IceCube20/JBC-FAE-Emulator/README.md

# JBC FAE Emulator – Control Your Own Fume Extractor with Your JBC Soldering Station Without the Original JBC FAE

> **New Projekt: Open Fume Extractor https://github.com/IceCube20/Open-Fume-Extractor**
> **Current development version:** **v2.3.66RC**  **Only ESP32**
> The original **V1.0** version is still part of this project.
This code runs on ESP32 and Arduino Mega.
Dual Bus (Max 2 JBC Soldering Stations).
With JBC DDE or DME you can set the relay afterrun in the Stations! The lower Models must the afterun configured in the Controler CLI (Arduino IDE Console).

**Emulates a JBC FAE base unit** with a robust P02 parser (DLE byte-stuffing, XOR BCC) on **two independent buses**.  
LED status (SK6812), relay after-run, persistence (NVS/EEPROM), and **RS-232 via MAX3232**.

> CLI over USB @ **115200**. Bus UARTs @ **250000 8E1**.  
> RS-232: **MAX3232** (3.0–5.5 V) converts between MCU-TTL (3V3/5V) and ±RS-232.

---

## Features

- **Dual bus** (BUS_COUNT=1|2), each bus with its own **DeviceID** & **address**
- **Relay** with **after-run** Configuring in the DDE and for lower Station Models over the CLI
- **Auto-save** for writes (debounced)
- **SK6812 GRBW** link/status per bus
- **Persistence**: ESP32 = **NVS** / Mega = **EEPROM**
- **RS-232** per bus via **DSub9 MAX3232 to ttl**

---

## CLI Example

-[NVS]
- bus0 DeviceID len=30 ascii="84495820251031014257F283" | addr=0x18
- bus1 DeviceID len=30 ascii="84495820251031014332F283" | addr=0x12
- [CLI] type 'help' for commands
- [CFG] buses=2 | tstop(w/s)=10/0 | selectflow=100 | suctionlevel=3 | stand_intakes=1 | filter(life/sat)=0/0 | stat_error=0 (0x0)
- [FW] 02:F2:EMU_02:8881031:0051123 | by IceCube20 | build Oct 31 2025 00:21:44
- > Commands:
- help                     - Show this Help
- ?                        - Show DEVID/Addr and other Data) 
- show cfg                 - Show the actual Configuration
- show buses               - Show actual selected Buscount
- set buses <1|2>          - select one or two JBC Stations to connect
- save / load              - Save or Load configuration Data from EEPROM
- erase [eeprom]           - clear NVS/EEPROM and reload defaults (use 'save' to persist) 
- set tstop_work <sec>     - Select the Relay afterrun time in seconds (for the DDE, you can set it up in the Stations Menu)
- set tstop_stand <sec>    - No function! Its for internal testing
- set suctionlevel <0..3>  - No function! Its for internal testing
- set selectflow <0..1000> - No function! Its for internal testing
- set stand_intakes <0|1>  - No function! Its for internal testing
- set filter_life <u16>    - Set your own Filterlife in % (shown in JBC DDE FAE Menu)
- set filter_sat <u16>     - Set your own Filtersaturation in % (shown in JBC DDE FAE Menu)
- STOPx/WARNx, NOERR, ERR  - STOP1-11 Set Station errors, WARN1-2 Set Station warnings, NOERR resets Stations errors or warnings and ERR show all Error and Warnings they exist

---

## Legal Notice

This project re-implements only functional protocol behavior (P02) for interoperability purposes.  
It contains no OEM firmware, no cryptographic keys, and does not circumvent any technical protection measures.  
Protocol constants, enums, and IDs are interface identifiers required for device communication.  
“JBC” is a trademark of its respective owners; this is an unofficial, independent project not affiliated with JBC S.A.

---

## Hardware & Pins

### ESP32 (defaults)

| Function | Pin |
|---:|:---:|
| BUS0 RX (Serial1) | 16  |
| BUS0 TX (Serial1) | 17  |
| BUS1 RX (Serial2) | 32  |
| BUS1 TX (Serial2) | 33  |
| SK6812 **LED_PIN** | 21  |
| Relay **RELAY_PIN** | 26  |
| MAX3232 **VCC** | 3V3 |

### Arduino Mega 2560 (defaults)

| Function | Pin |
|---:|:---:|
| BUS0 RX (Serial1) | 19 (RX1) |
| BUS0 TX (Serial1) | 18 (TX1) |
| BUS1 RX (Serial2) | 17 (RX2) |
| BUS1 TX (Serial2) | 16 (TX2) |
| SK6812 **LED_PIN** | 6 |
| Relay **RELAY_PIN** | 7 |
| MAX3232 **VCC** | 5V  |

> **Note:** MAX3232 works with **3.3 V (ESP32)** and **5 V (Mega)**.  
> **GND** must be **common** between MCU and MAX3232.

---

## Wiring Diagram ESP32

<p align="center">
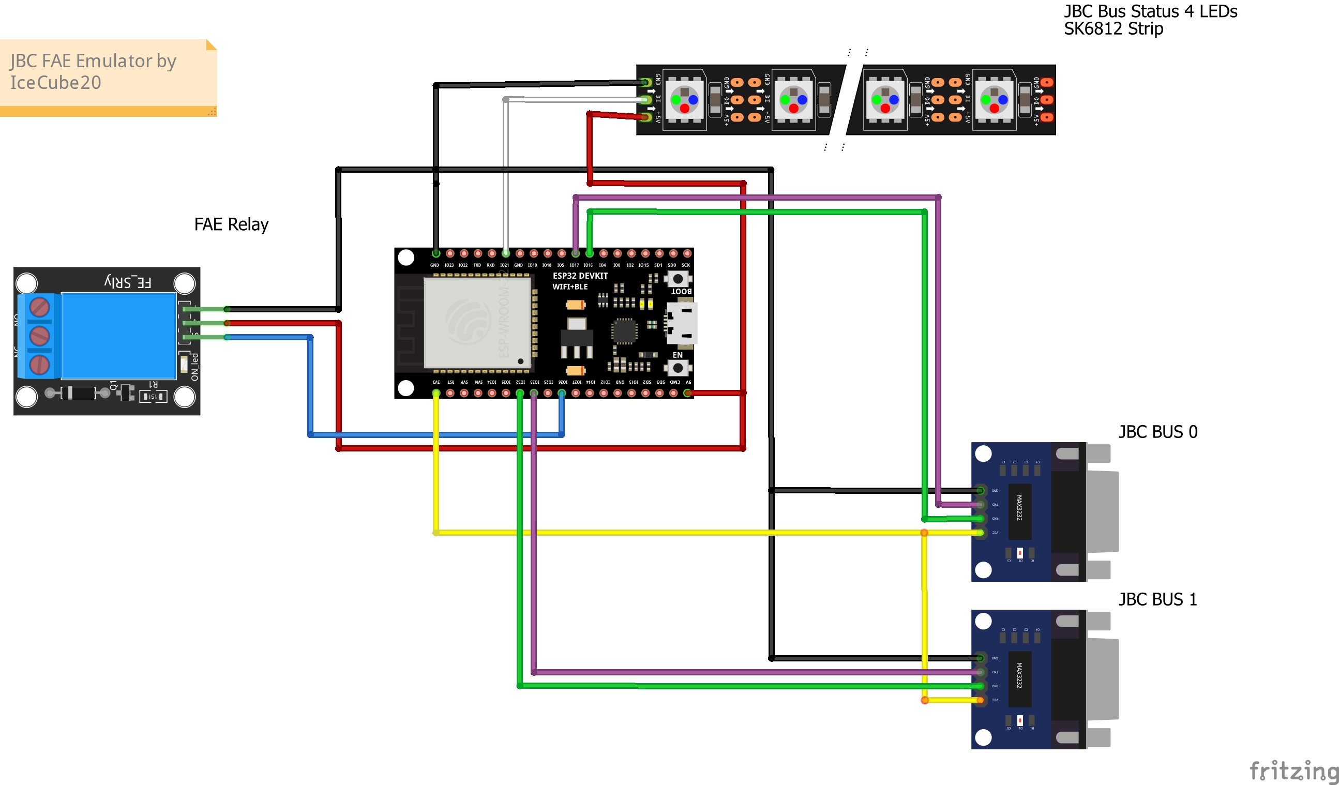
[picture p1: JBC FAE Emulator_Steckplatine.jpg]
  
</p>

---

## Wiring Diagram Arduino Mega

<p align="center">
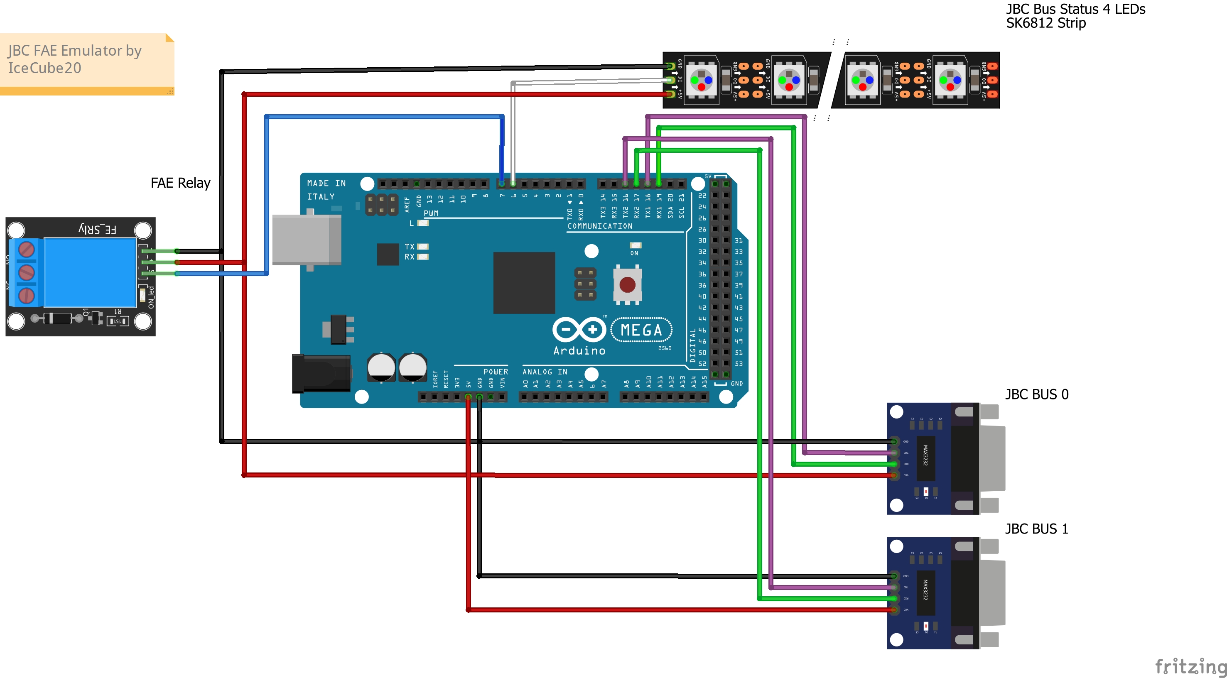
[picture p2: JBC FAE Emulator Arduino Mega_Steckplatine.jpg]
  
</p>

---
## Wiring Diagram JBC Station Cable

<p align="center">
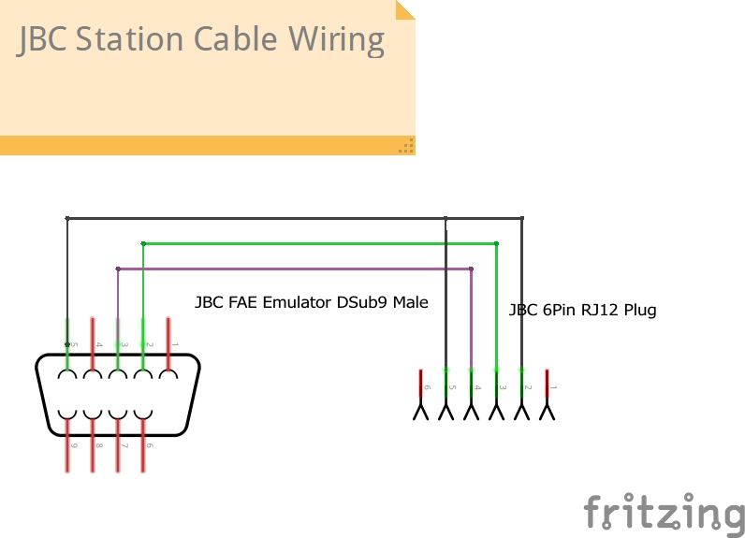
[picture p3: JBC Station Wiring.jpg]
JBC Link wiring diagram
  
</p>

---
