IceCube20/JBC-FAE-Emulator/(commit log)

2025-10-24 Remove circuit diagram from README
    Removed detailed circuit diagram in Mermaid format for ESP32 and MAX3232 connections.
2025-10-24 Enhance README with wiring diagram section
    Added wiring diagram and SVG version note to README.
2025-10-24 Update wiring diagram image format in README
2025-10-24 Revise RS-232 wiring and pin configuration in README
    Updated RS-232 wiring instructions and pin assignments for ESP32.
2025-10-24 Add wiring diagram for Arduino Mega
2025-10-24 Add wiring diagram for JBC Station cable
2025-10-24 3D housing for variant ESP32 FAE Emulator
2025-10-30 Bugfixes and other changes
    [JBC_FAE_SIM_ESP32_DUAL_PORT.ino, jbc_FE_commands_full.h]
2026-03-28 Fix formatting in README for current version info
2026-09-15 Update README with new project and version info
    Updated the current development version and added a new project link.
